asmaslov/ignitor/doc/ignitor.pdf

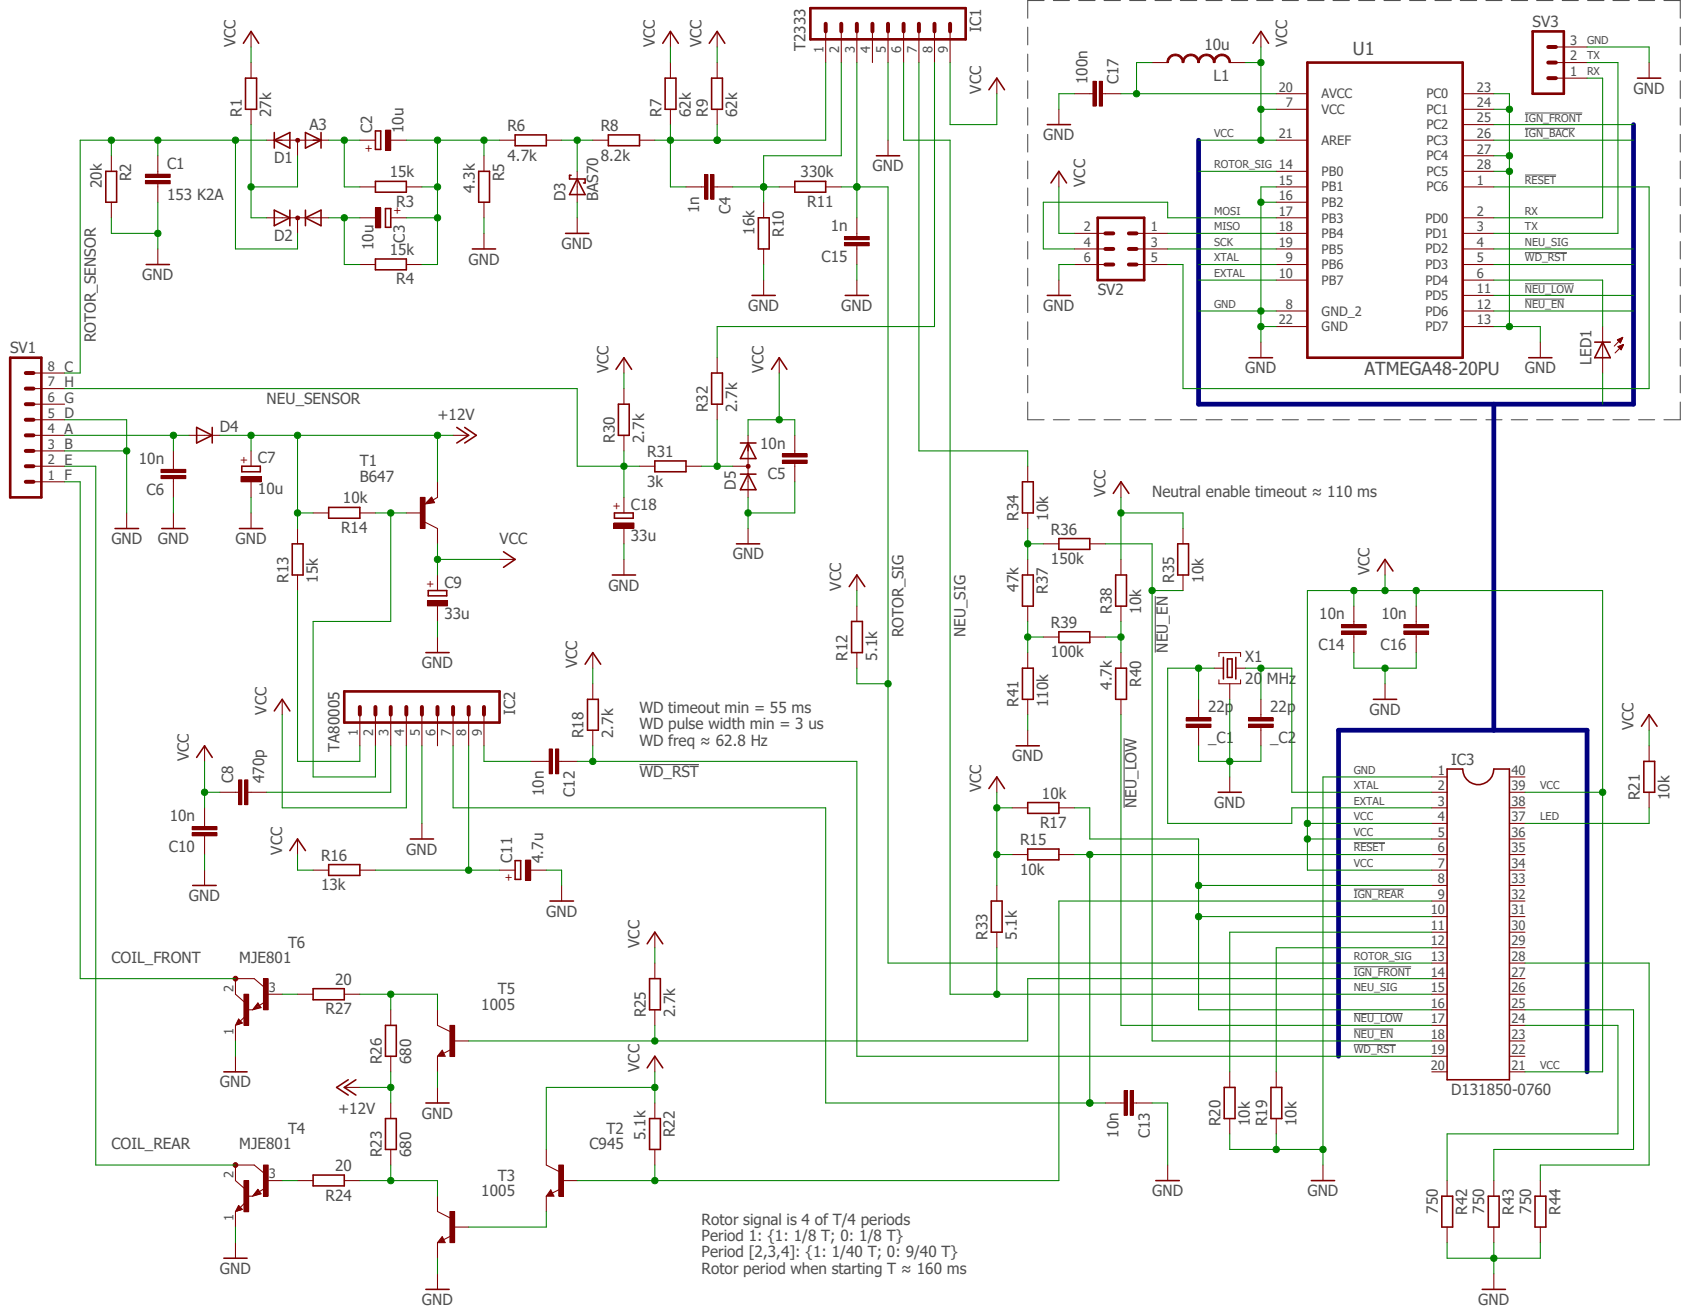
[picture p6: page 1]

Neutral enable timeout ≈ 110 ms

WD timeout min = 55 ms
WD pulse width min = 3 us
WD freq ≈ 62.8 Hz

VCC 7

IGN_REAR 9

11
12

ROTOR_SIG 13

NEU_SIG 15

Rotor signal is 4 of T/4 periods
Period 1: {1: 1/8 T; 0: 1/8 T}
Period [2,3,4]: {1: 1/40 T; 0: 9/40 T}
Rotor period when starting T ≈ 160 ms
