asmaslov/ignitor/board/ignitor.sch

## EAGLE design board/ignitor.sch (2023-04-12)

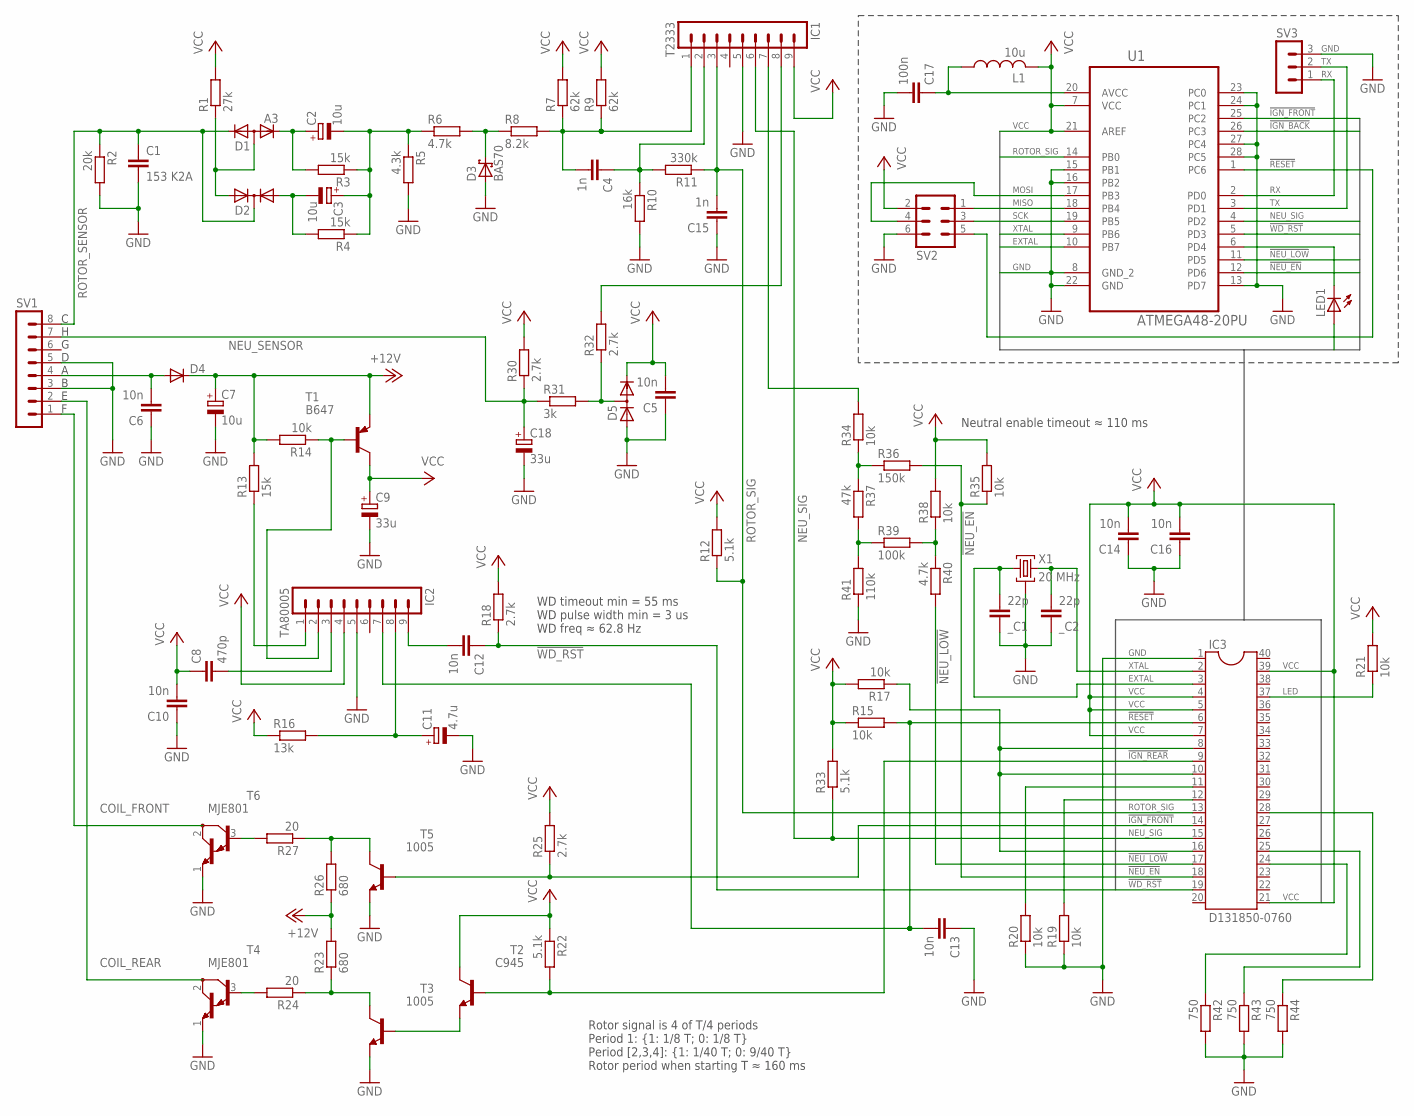
[picture p7: schematic ignitor.sch]

Parts:
C1: 153 K2A; C050-030X075
C2, C3, C7: 10u; E2,5-5
C4, C15: 1n; C0805
C5, C6, C10, C12, C13, C14, C16: 10n; C0805
C8: 470p; C0805
C9, C18: 33u; E2,5-5
C11: 4.7u; E2,5-5
C17: 100n; C050-024X044
D1: A3; SOT23
D2: DIODE-2AC|CASOT23; SOT23
D3: BAS70; SOT23
D4: DIODE-MINIMELF; MINIMELF
D5: DIODE_2CACA-SOT23; SOT23
IC1: T2333; MA09-1
IC2: TA80005; MA09-1
IC3: D131850-0760; DIL40
L1: 10u; 0204/5
LED1: LED3MM
R1: 27k; R0805
R2: 20k; R0805
R3, R4, R13: 15k; R0805
R5: 4.3k; R0805
R6, R40: 4.7k; R0805
R7, R9: 62k; R0805
R8: 8.2k; R0805
R10: 16k; R0805
R11: 330k; R0805
R12, R22, R33: 5.1k; R0805
R14, R15, R17, R19, R20, R21, R34, R35, R38: 10k; R0805
R16: 13k; R0805
R18, R25, R30, R32: 2.7k; R0805
R23, R26: 680; R2512
R24, R27: 20; R0805
R31: 3k; R0805
R36: 150k; R0805
R37: 47k; R0805
R39: 100k; R0805
R41: 110k; R0805
R42, R43, R44: 750; R0805
SV1: MA08-1
SV2: MA03-2
SV3: MA03-1
T1: B647; TO92
T2: C945; TO92
T3, T5: 1005; TO92
T4, T6: MJE801; TO126
U1: ATMEGA48-20PU; DIP254P762X457-28
X1: 20 MHz; HC49U
_C1, _C2: 22p; C0805

Connections:
!IGN_BACK: U1.26 (PC3)
!IGN_FRONT: IC3.14, R25.1, T5.2 (B), U1.25 (PC2)
!IGN_REAR: IC3.9, R22.2, T2.2 (B)
!NEU_EN: IC3.18, R35.1, R36.2, U1.12 (PD6)
!NEU_LOW: IC3.17, R40.2, U1.11 (PD5)
!RESET: C13.2, IC2.7, IC3.6, R15.2, SV2.5, U1.1 (PC6)
!WD_RST: C12.1, IC3.19, R18.1, U1.5 (PD3)
+12V: C7.+, D4.C, R13.2, R14.2, R23.2, R26.1, T1.1 (E)
COIL_FRONT: SV1.1, T6.2 (C)
COIL_REAR: SV1.2, T4.2 (C)
EXTAL: IC3.3, U1.10 (PB7), X1.1, _C1.2
GND: C1.2, C5.1, C6.1, C7.-, C9.-, C10.1, C11.-, C13.1, C14.1, C15.1, C16.1, C17.2, C18.-, D3.1 (A), D5.1 (A), IC1.5, IC2.5, IC3.1, R2.2, R5.2, R10.2, R19.1, R20.1, R41.1, R42.2, R43.2, R44.2, SV1.3, SV1.5, SV2.6, SV3.3, T3.1 (E), T4.1 (E), T5.1 (E), T6.1 (E), U1.8 (GND_2), U1.13 (PD7), U1.15 (PB1), U1.16 (PB2), U1.22 (GND), U1.23 (PC0), U1.24 (PC1), U1.27 (PC4), U1.28 (PC5), X1.2, _C1.1, _C2.1
LED: IC3.37, LED1.A, R21.1
MISO: SV2.1, U1.18 (PB4)
MOSI: SV2.4, U1.17 (PB3)
unnamed: R27.2, T6.3 (B)
unnamed: C12.2, IC2.9
unnamed: D1.3 (A), D2.2 (A2), R1.1
unnamed: C3.-, D2.1 (A1), R4.2
unnamed: C2.-, C3.+, R3.1, R4.1, R5.1, R6.1
unnamed: C2.+, D1.1 (K1), R3.2
unnamed: LED1.K (C), U1.6 (PD4)
unnamed: C17.1, L1.1, U1.20 (AVCC)
unnamed: D3.3 (C), R6.2, R8.1
unnamed: C4.2, IC1.1, R7.1, R8.2, R9.1
unnamed: C4.1, IC1.2, R10.1, R11.2
unnamed: D5.3 (AC), R31.2, R32.1
unnamed: R34.1, R36.1, R37.1
unnamed: R37.2, R39.1, R41.2
unnamed: IC1.7, R34.2
unnamed: C6.2, D4.A, SV1.4
unnamed: IC2.2, R14.1, T1.2 (B)
unnamed: C8.2, IC2.3
unnamed: IC2.1, R13.1
unnamed: C11.+, IC2.8, R16.2
unnamed: T2.1 (E), T3.2 (B)
unnamed: R24.2, T4.3 (B)
unnamed: R26.2, R27.1, T5.3 (C)
unnamed: R23.1, R24.1, T3.3 (C)
unnamed: IC3.12, R19.2
unnamed: IC3.8, IC3.10, IC3.16, R17.1
unnamed: IC3.24, R42.1
unnamed: IC3.11, R20.2
unnamed: IC3.28, R44.1
unnamed: IC3.25, R43.1
unnamed: R38.1, R39.2, R40.1
unnamed: IC1.8, R32.2
NEU_SENSOR: C18.+, R30.1, R31.1, SV1.7
NEU_SIG: IC1.6, IC3.15, R33.1, U1.4 (PD2)
ROTOR_SENSOR: C1.1, D1.2 (K2), D2.3 (C), R2.1, SV1.8
ROTOR_SIG: C15.2, IC1.3, IC3.13, R11.1, R12.1, U1.14 (PB0)
RX: SV3.1, U1.2 (PD0)
SCK: SV2.3, U1.19 (PB5)
TX: SV3.2, U1.3 (PD1)
VCC: C5.2, C8.1, C9.+, C10.2, C14.2, C16.2, D5.2 (C), IC1.9, IC2.4, IC3.4, IC3.5, IC3.7, IC3.21, IC3.39, L1.2, R1.2, R7.2, R9.2, R12.2, R15.1, R16.1, R17.2, R18.2, R21.2, R22.1, R25.2, R30.2, R33.2, R35.2, R38.2, SV2.2, T1.3 (C), T2.3 (C), U1.7 (VCC), U1.21 (AREF)
XTAL: IC3.2, U1.9 (PB6), X1.3, _C2.2

Notes on the sheet:
WD timeout min = 55 ms WD pulse width min = 3 us WD freq ≈ 62.8 Hz
Neutral enable timeout ≈ 110 ms
Rotor signal is 4 of T/4 periods Period 1: {1: 1/8 T; 0: 1/8 T} Period [2,3,4]: {1: 1/40 T; 0: 9/40 T} Rotor period when starting T ≈ 160 ms
