asmaslov/ignitor/(commit log)

2021-07-26 Memory keep
    [ignitor.sch]
2021-07-26 Uart debug
2021-07-28 Fixed parser
    [ignitor.sch]
2021-08-06 Moved to cpp
    [ignitor.sch]
2023-04-12 Project updated
    [ignitor.sch]
